ctz16/PF-H_FeedbackControl/ref/Development of Plasma Feedback Control System in TST-2 - Copy.pptx

## Development of Plasma Feedback Control System in TST-2 Spherical Tokamak

Chang Tingzhi
2019. 8.27

## Introduction

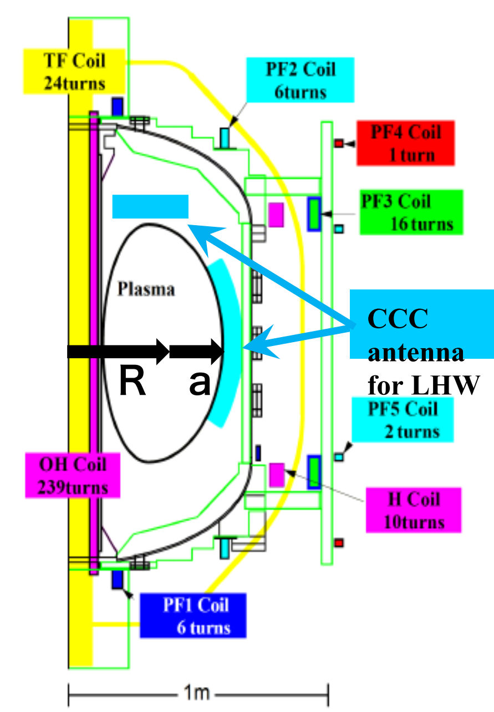
[picture p4: figure]

- In TST-2, PF3 and H coil are used to control the horizontal and vertical position of plasma
- The current waveform of coils is controlled by sending preprogrammed signals to the IGBTs. The waveform is adjusted manually.

## Introduction

- The feedback control system serves to control the plasma position automatically according to a real-time calculation of plasma position, which helps to get a more stable plasma position especially during a long-lasting discharge

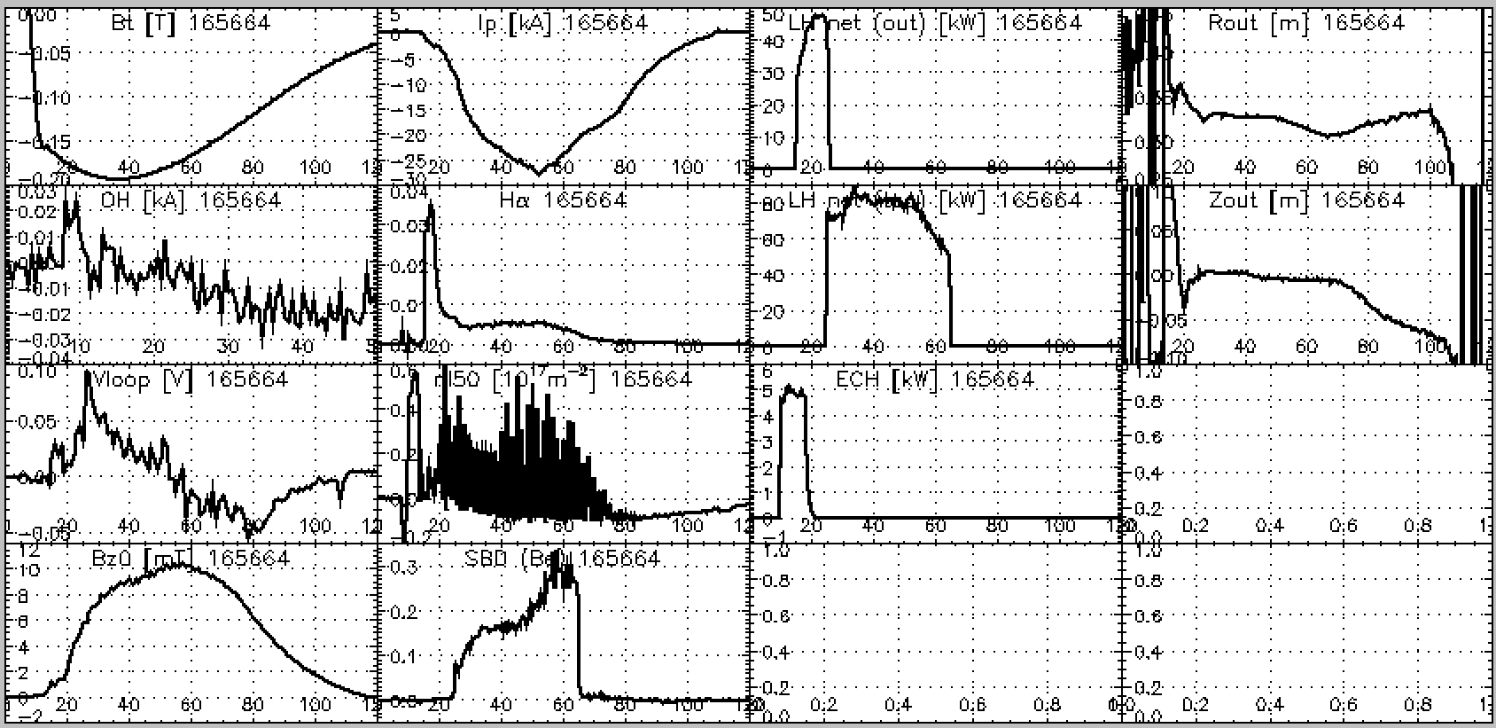
[picture p5: figure]
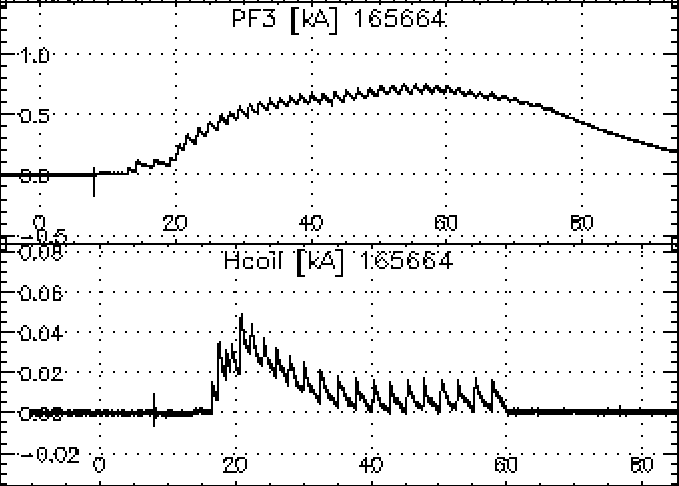
[picture p6: figure]

## Sketch of Control System


- In idle time, controller works to communicate and calculate signal offsets due to integrator offsets.
- Preprogrammed waves and all calibration coefficients can be sent by TCP communication
- When trigger comes in, trigger flag is set by interrupt, the controller will enter controlling process in next loop

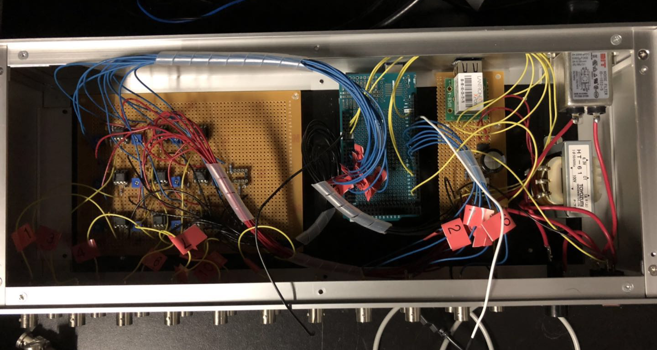
[picture p7: figure]
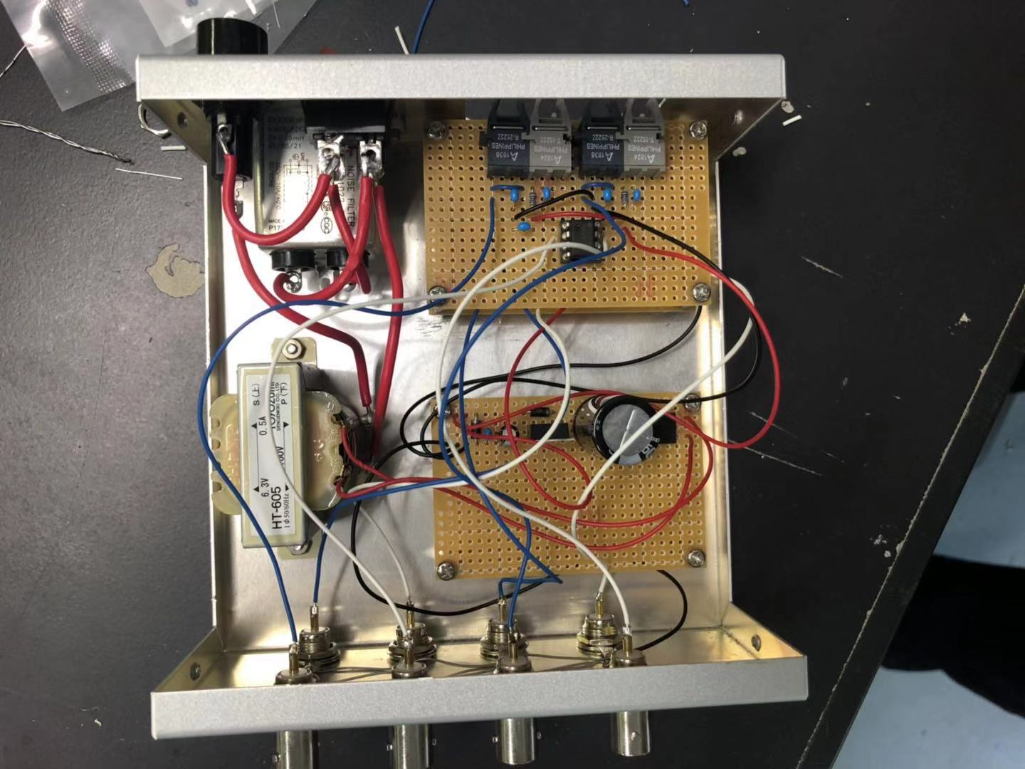
[picture p8: figure]
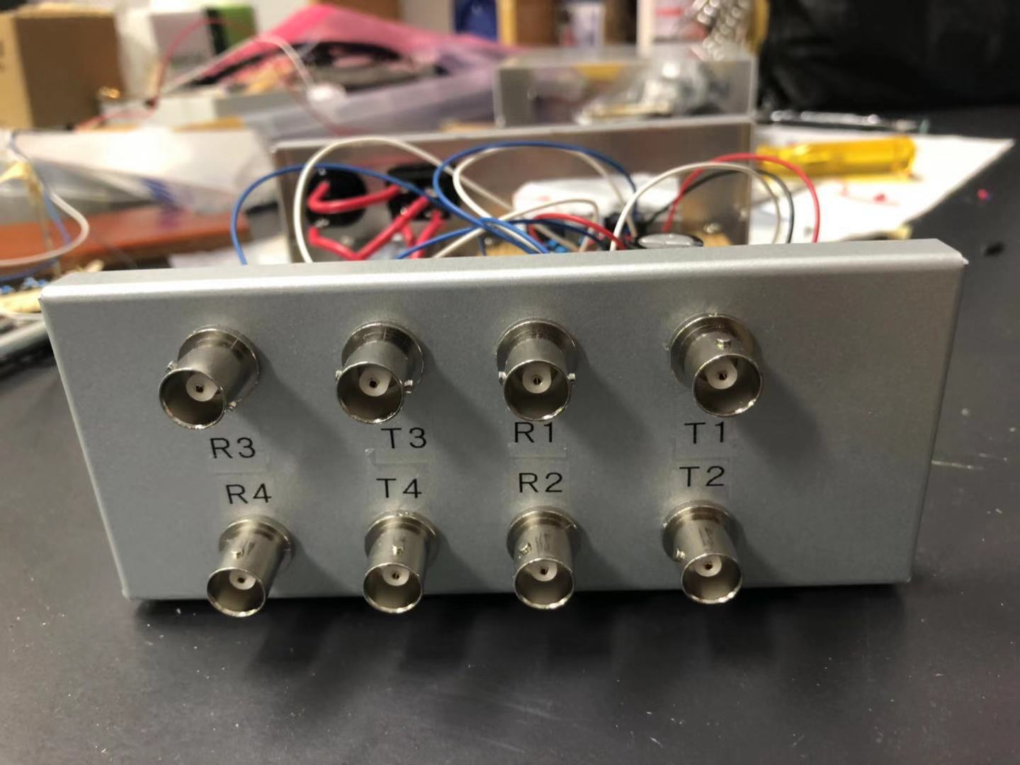
[picture p9: figure]

## IGBT circuit

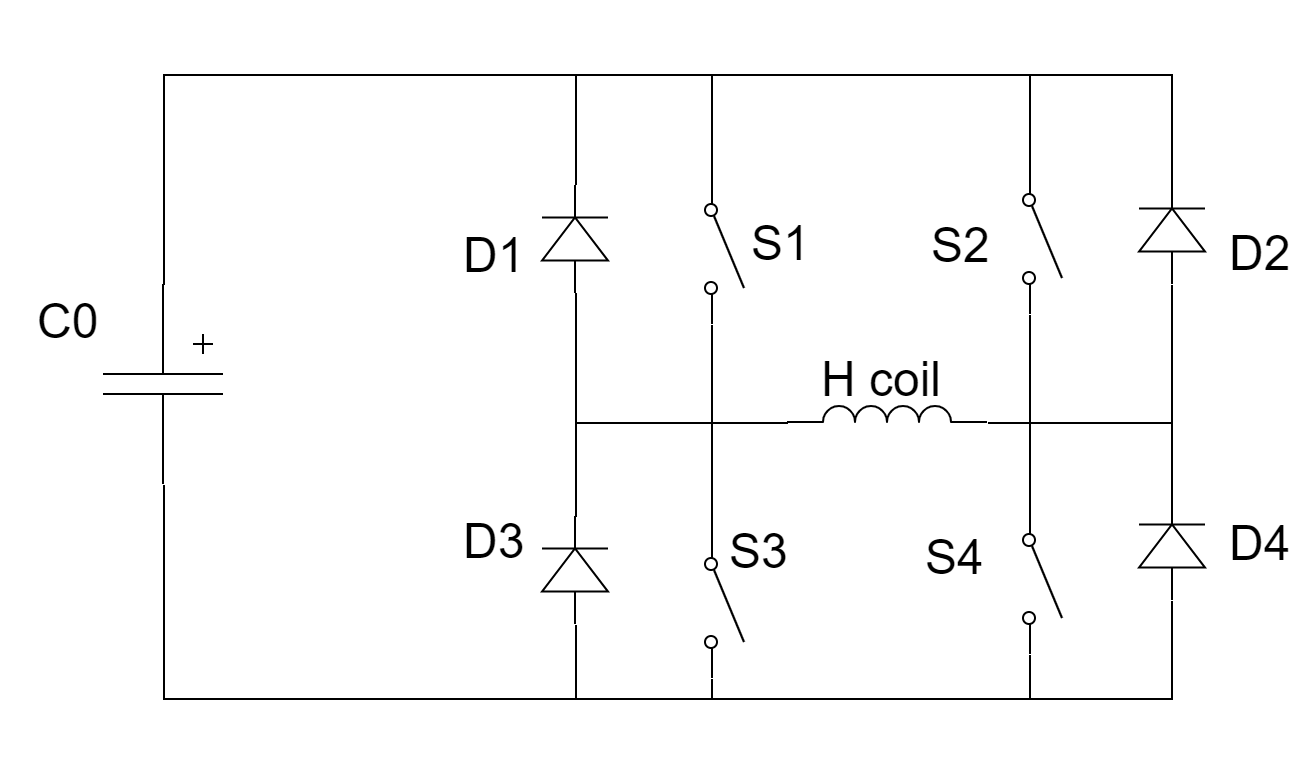
[picture p10: figure]

- H coil control (current flows two direction: H bridge)
  - Group1: S1 & S4 (PWM)
  - Group2: S2 & S3 (PWM)
- PF3 coil control
  - S0 (PWM)

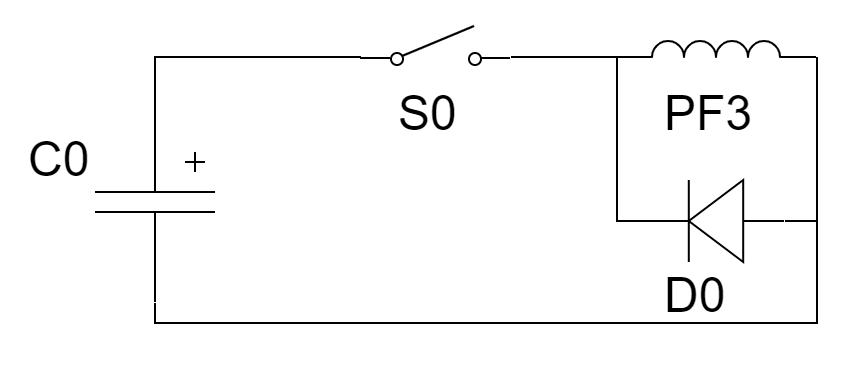
[picture p11: figure]

## Position Control

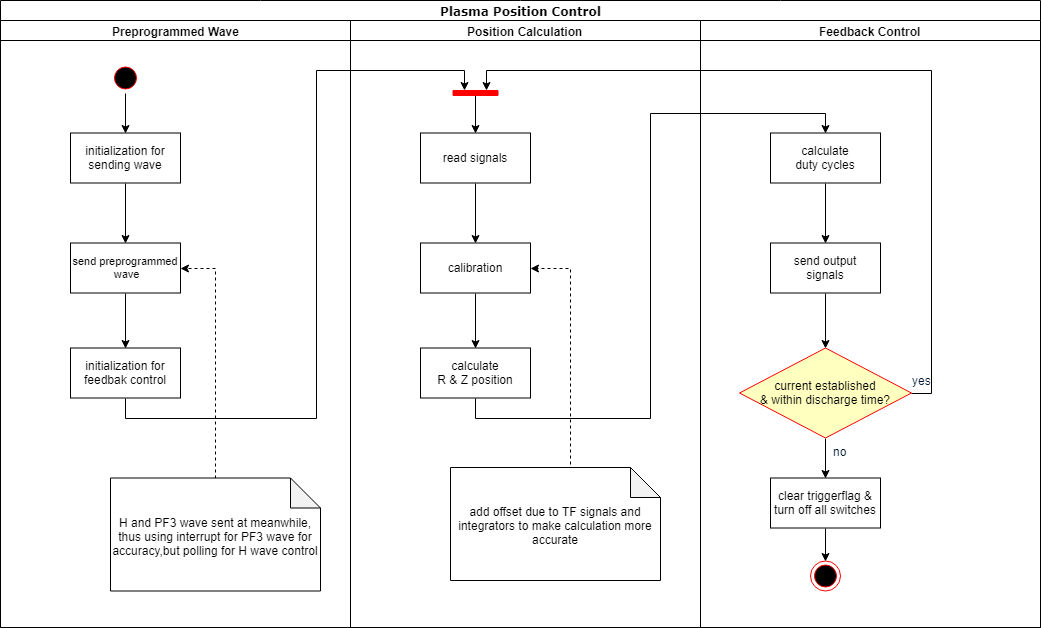
[picture p12: figure]

## Plasma position calculation

Z position:
Fitting of seven magnetic flux in a vertical line, take the position of the minimum value as central z position of plasma
R position:
take the middle of central and outboard flux loop, with a calibration term by ψ
R_(out) =1/2×(R_o +R_c +((ψ_c −ψ_o ))/((dψ)/(dR)))

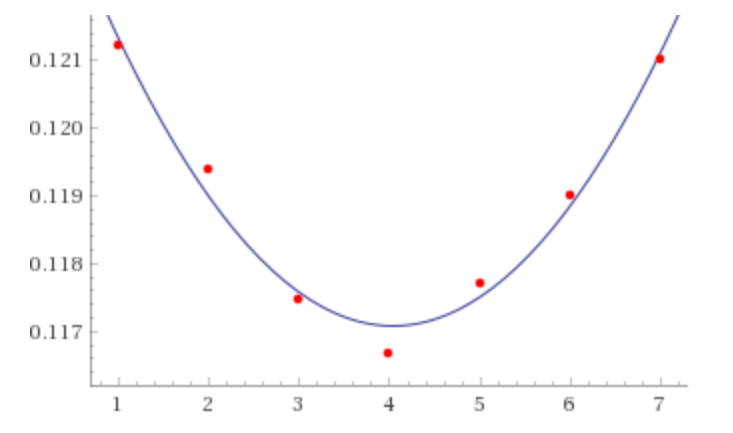
[picture p13: figure]

Z_(out)

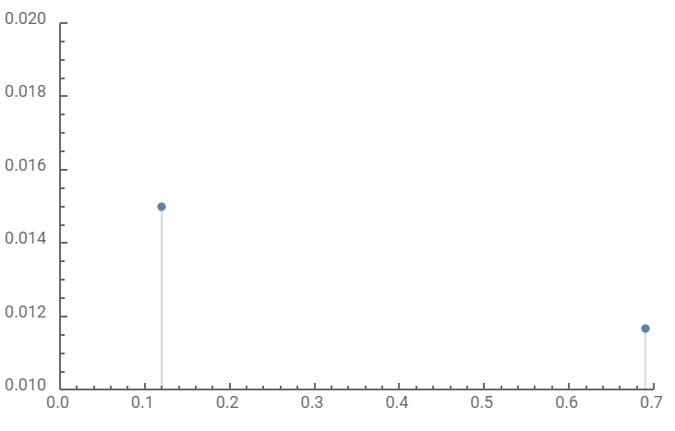
[picture p14: figure]

R_C

R_(out)

R_o

## Feedback control

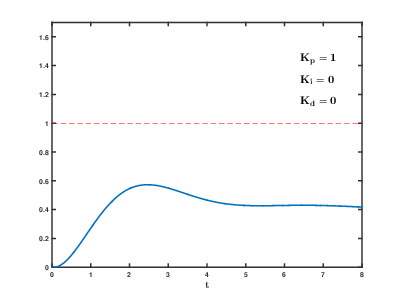
[picture p15: figure]

- PI control
d(t)=K_p e(t)+K_i ∑_0^t e(t)
e_x (t)=x_(out) −x_(target) , x=R,z
- Tuning
  - Increase of P coefficient shows an increase of oscillation but the system reacts faster
  - Increase of I coefficient accelerates convergence, but may cause the overshot at the beginning

## Calculation results (LH)

+++ controller results

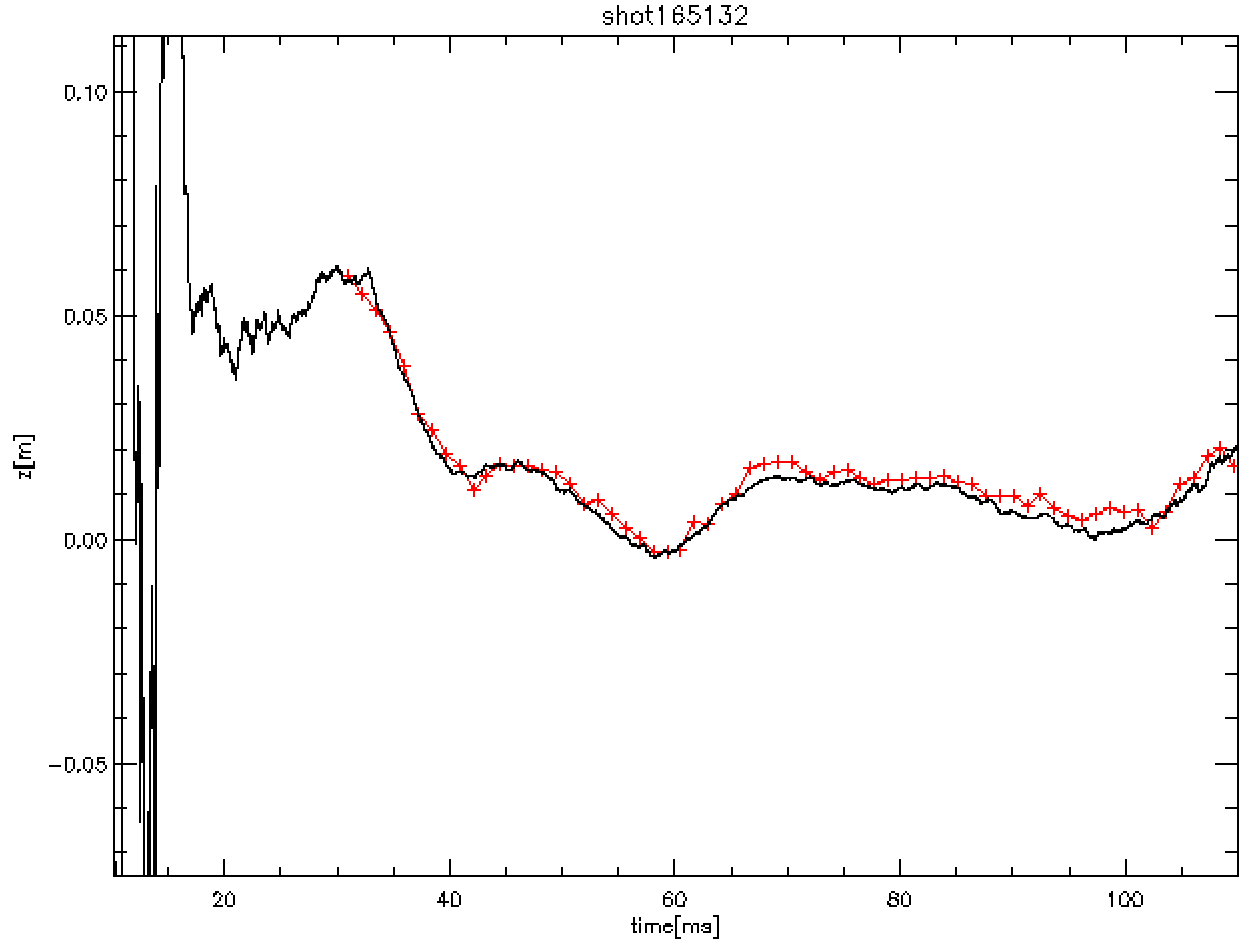
[picture p16: figure]
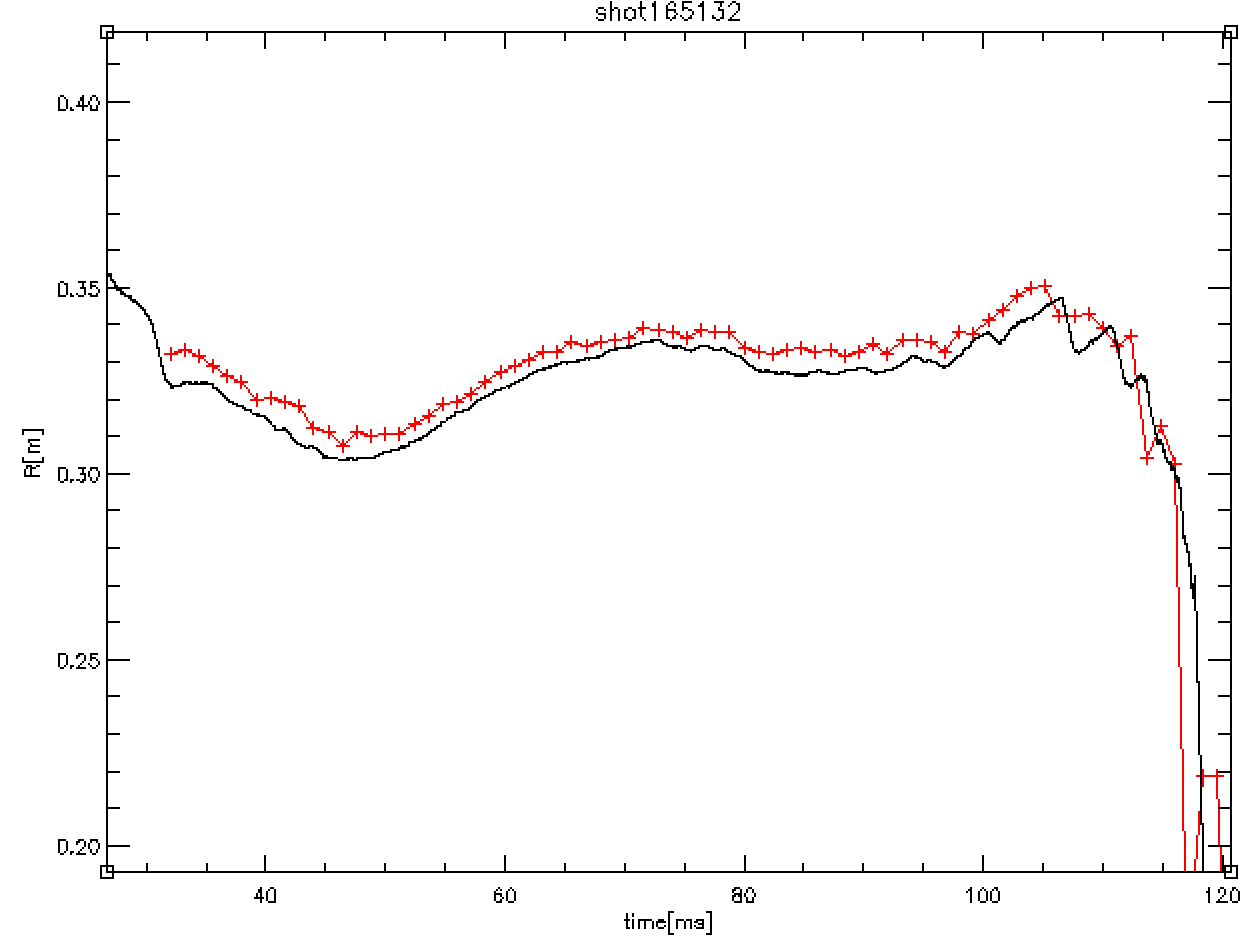
[picture p17: figure]

- A systematic error generally within 1cm (get better when applied noise reduce, TF offset calibration may not be accurate)
- Z calculation is more accurate than R due to TF offset in R calculation

## Calculation results (OH)

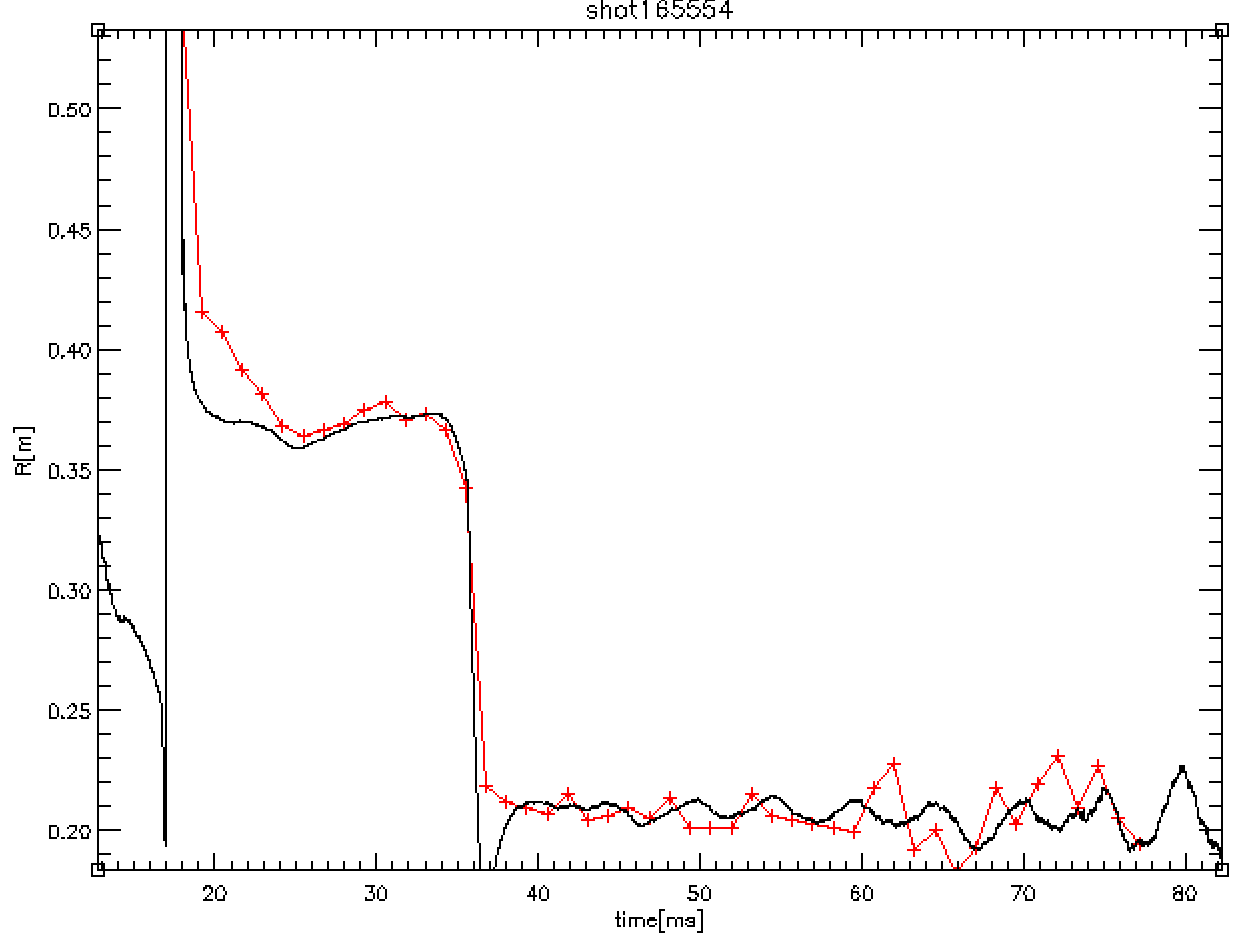
[picture p18: figure]
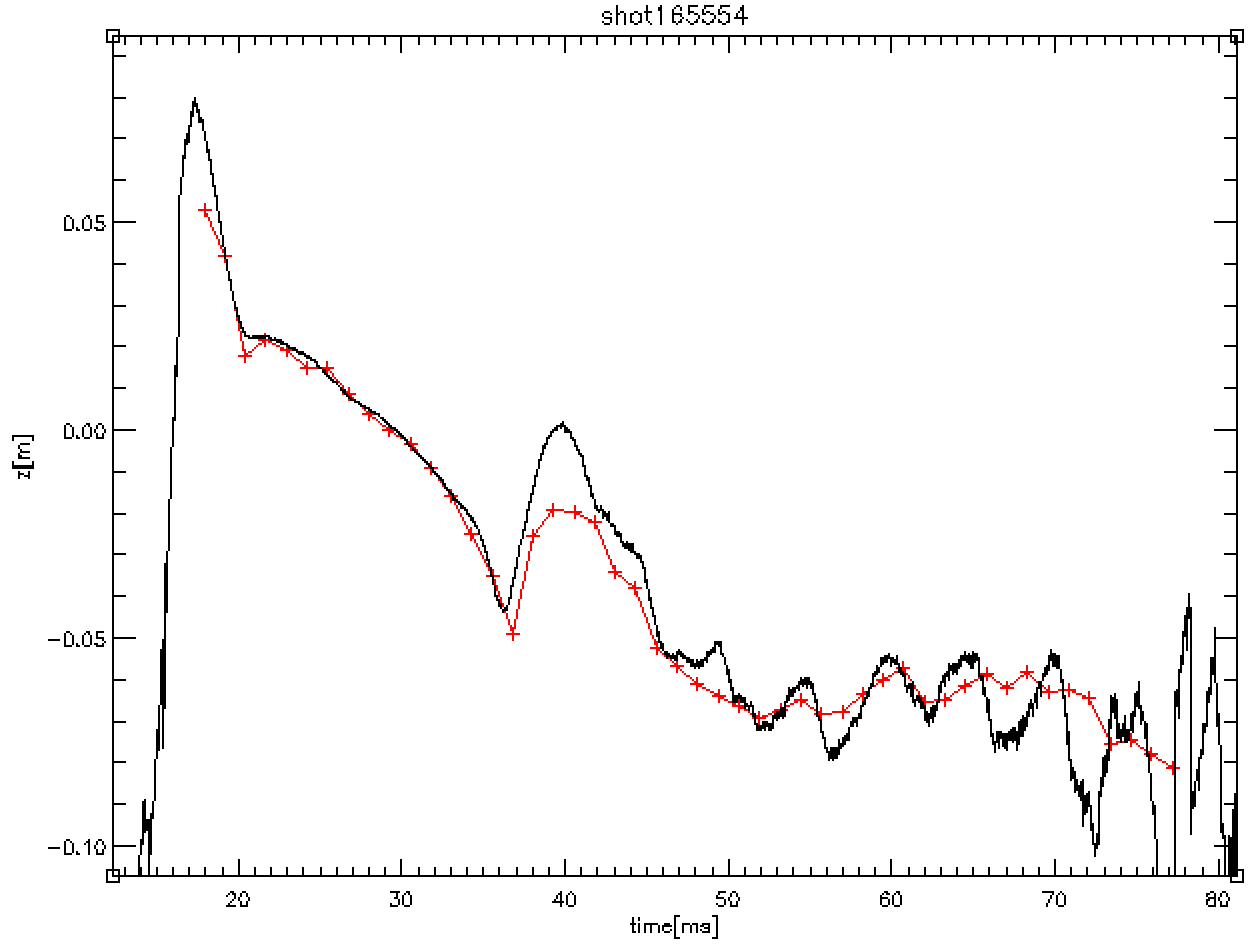
[picture p19: figure]

- Improvement of TF calculation helps to improve R calculation
- Calculation less accurate when signal changes quickly or signal is weak
- Arduino calculation is slow, may not be able to control Ohmic discharge

## Controlling results (LH experiment)

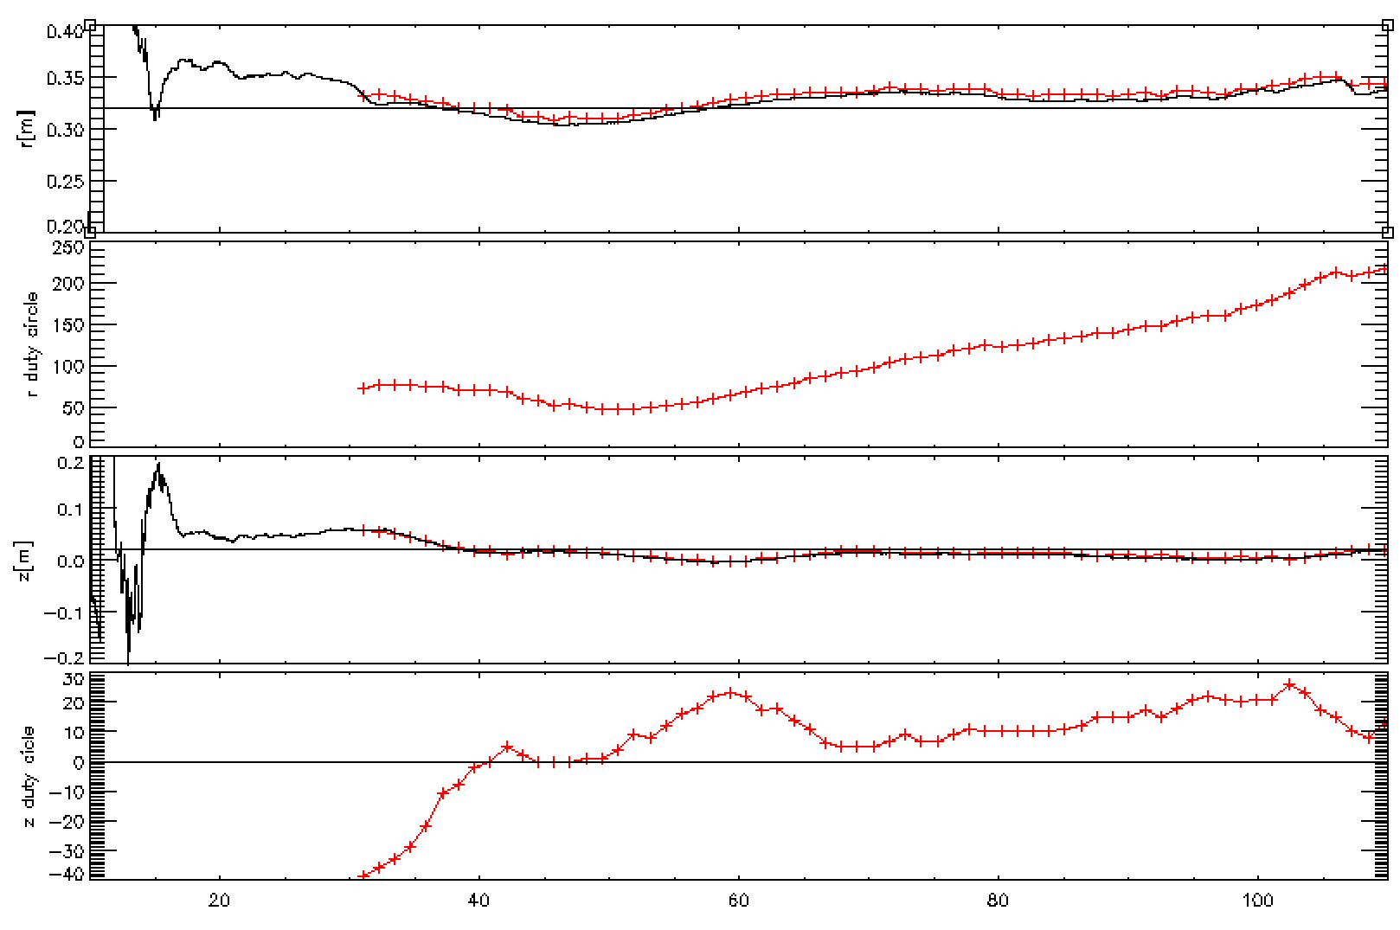
[picture p20: figure]

- Plasma position was controlled at the target with an maximum error of about 2 cm, stability was improved by adjusting PI parameters
- The speed of Arduino is enough to control LH discharge

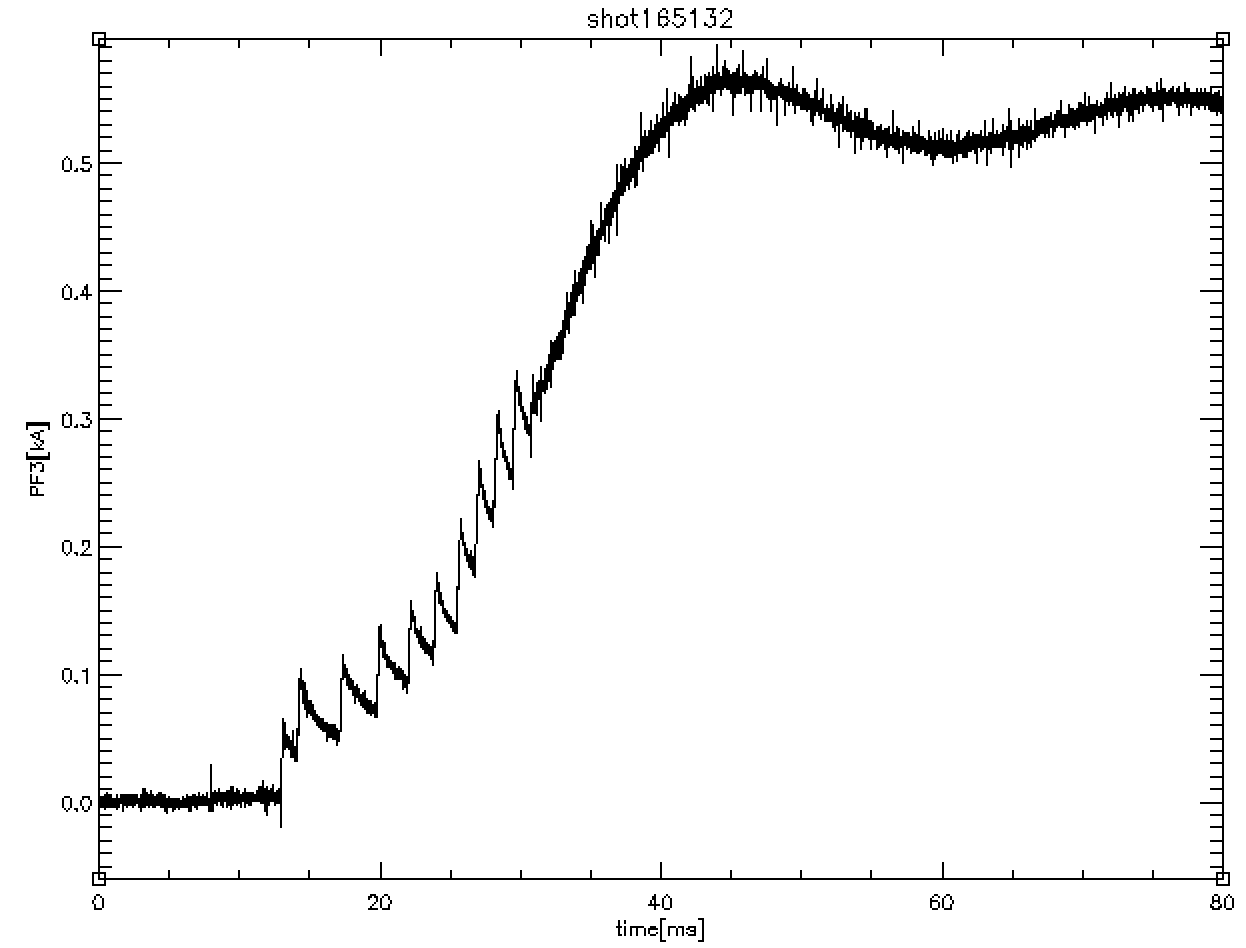
[picture p21: figure]
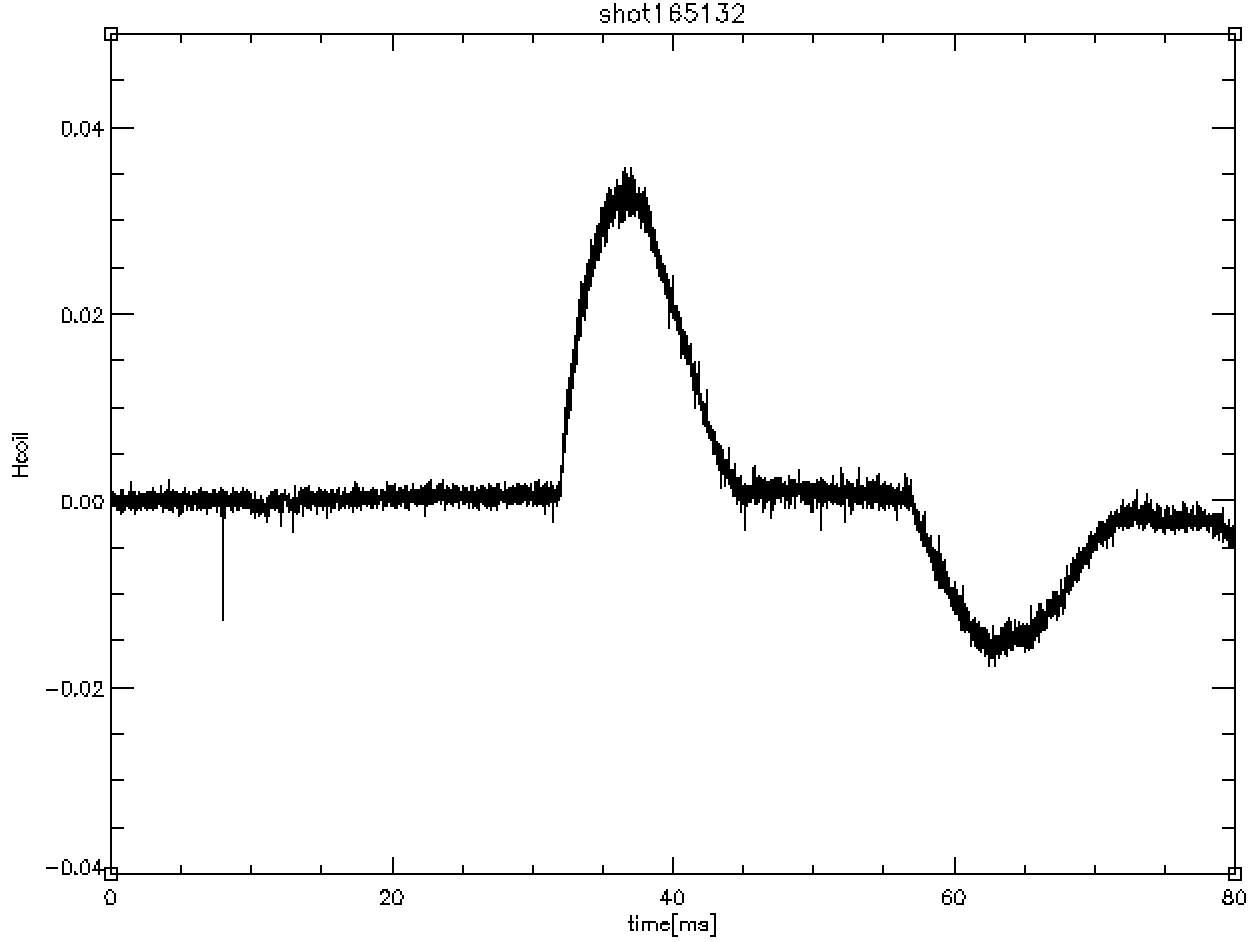
[picture p22: figure]

## Parameter Scan: z target

z target [m]:
—— 0.04 —— 0.02

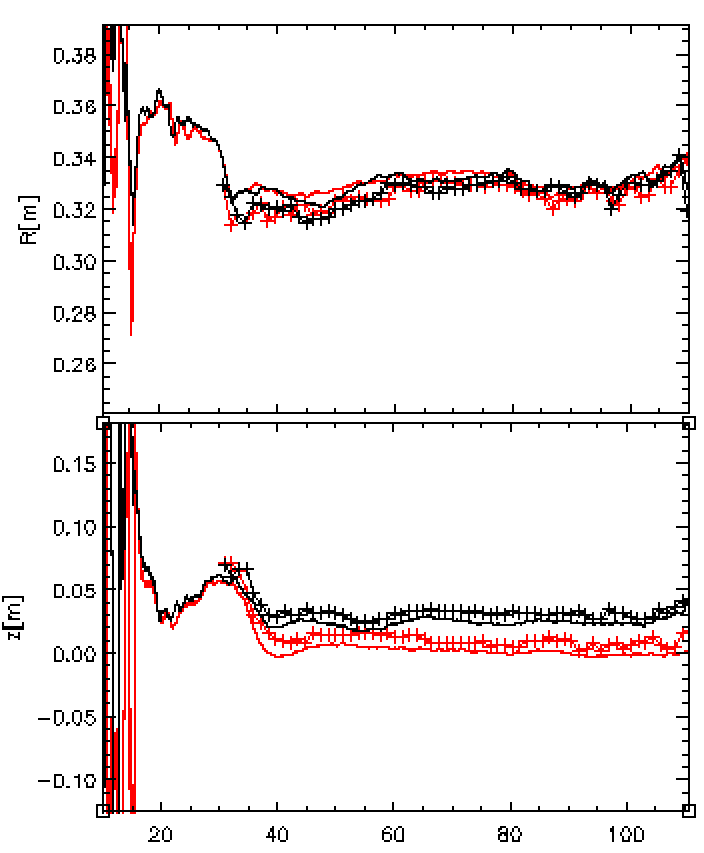
[picture p23: figure]
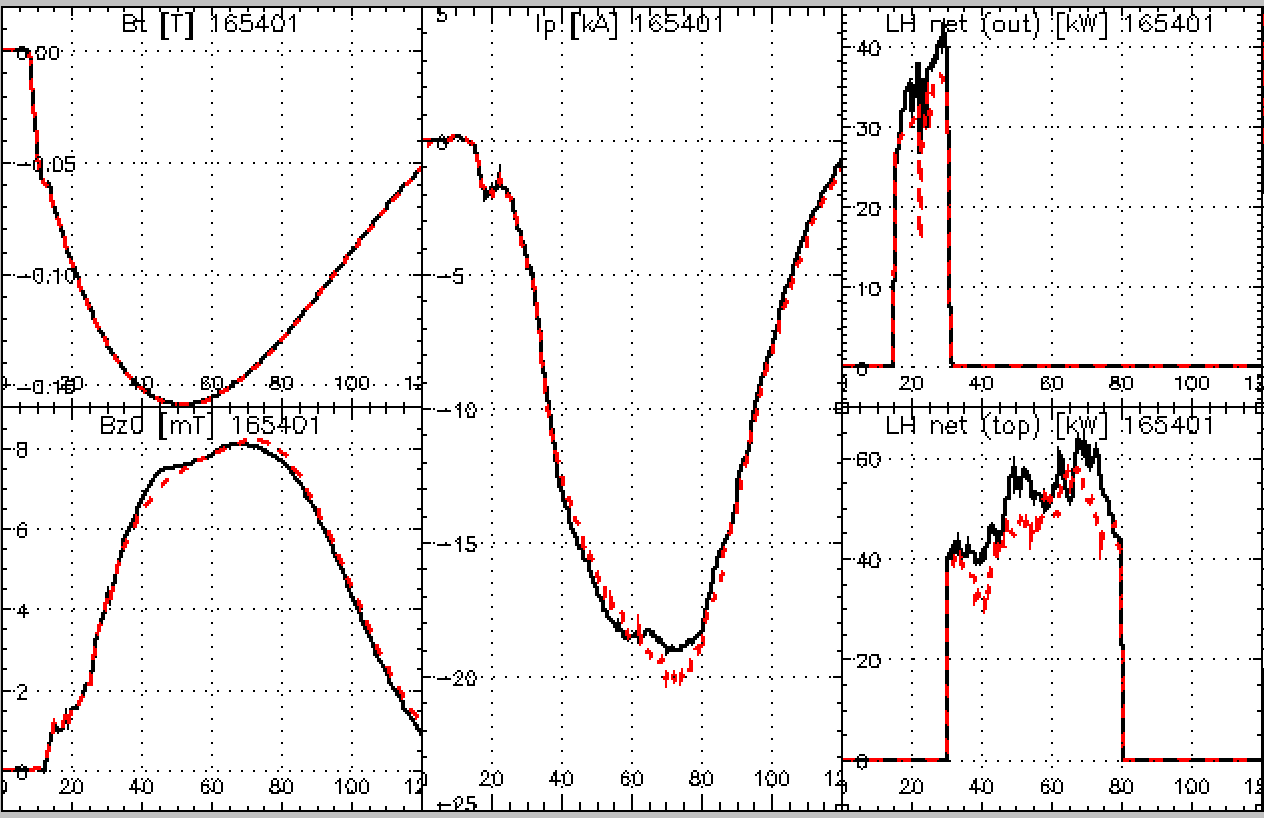
[picture p24: figure]

Changing z target didn’t show a big influence on plasma confinement

## Parameter scan: R target

R target [m]:
—— 0.31 —— 0.32 —— 0.33

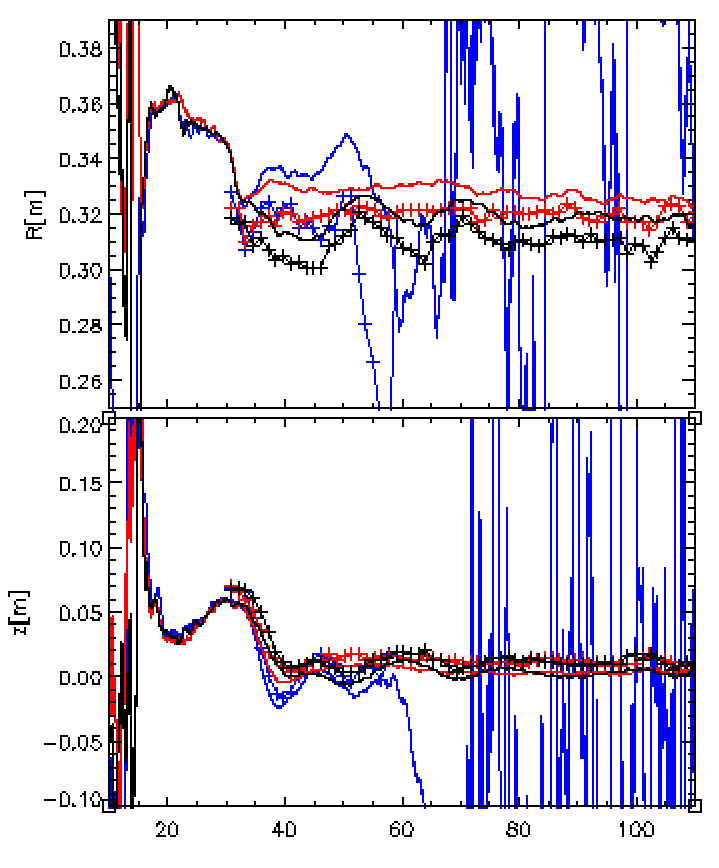
[picture p25: figure]
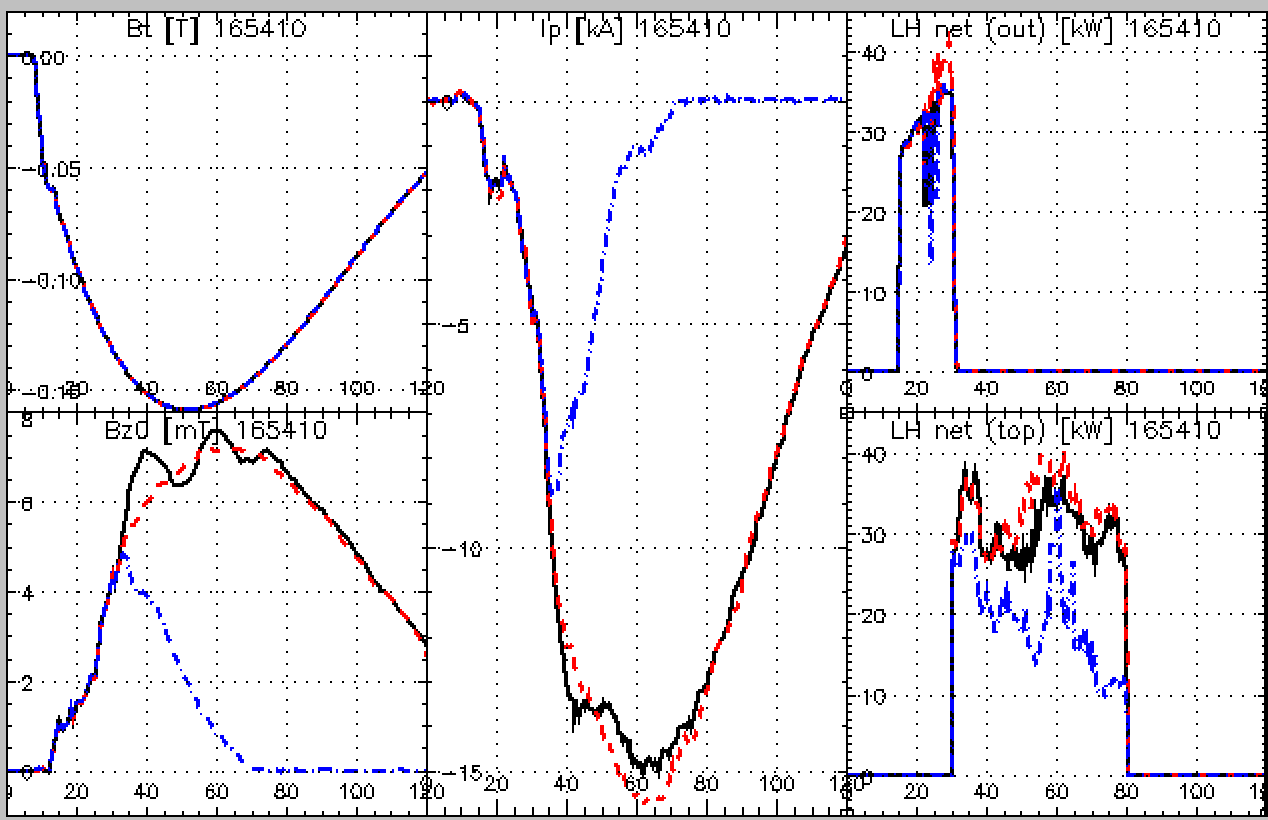
[picture p26: figure]

Plasma showed a sensitive reaction of R position, when R target is bigger, plasma current is more easy to break up (when the target is set to 0.33), optimum R target is around 0.32m,
less oscillation helps to improve current

## Parameter scan: B_t

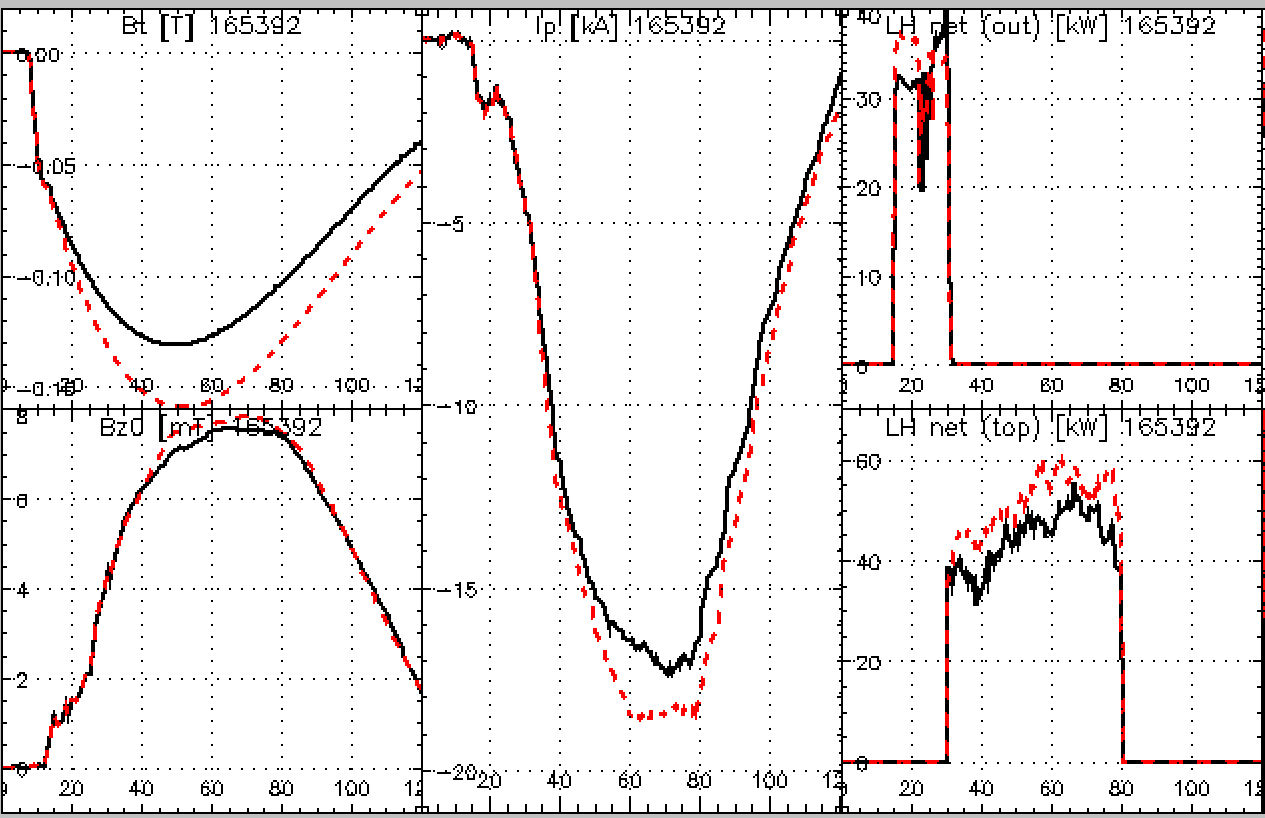
[picture p27: figure]

Bigger toroidal field shows improvement of confinement

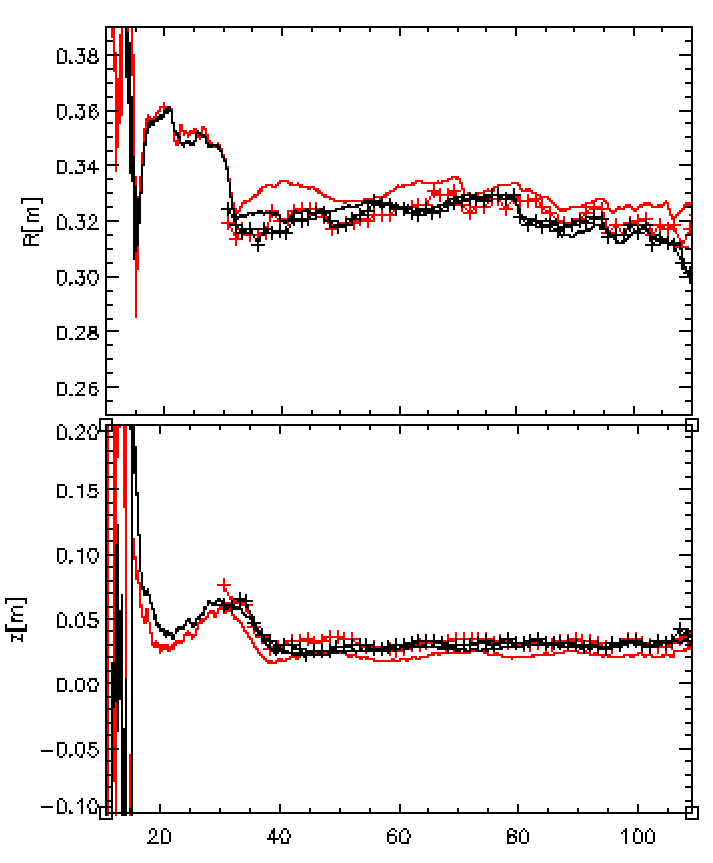
[picture p28: figure]

## Parameter scan: LH power

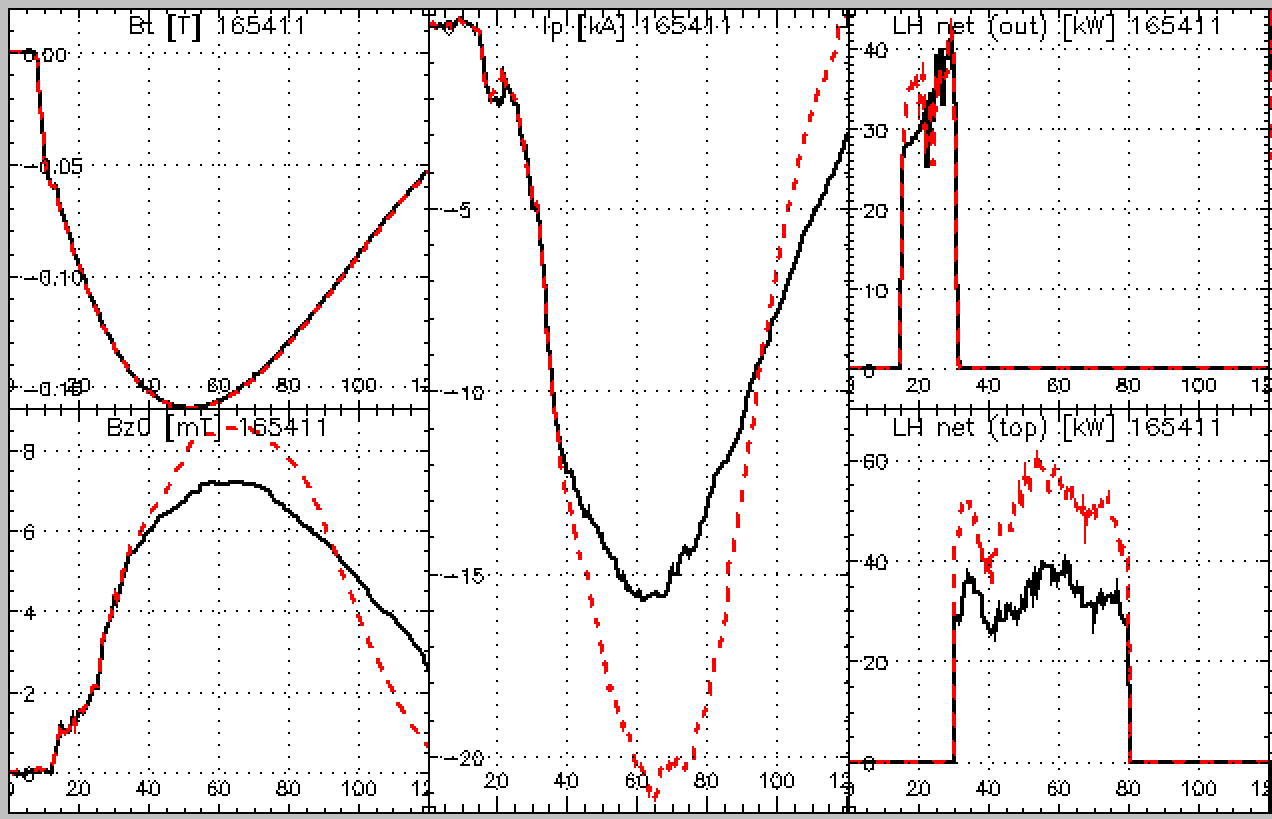
[picture p29: figure]
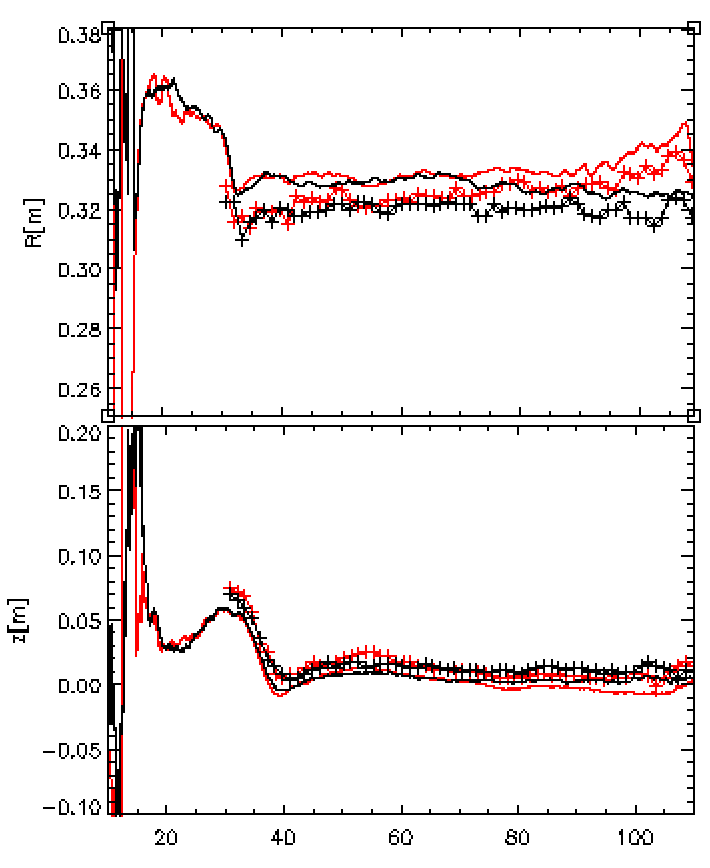
[picture p30: figure]

bigger LH power drives bigger current, but the current dropped faster

## Parameter scan: antenna

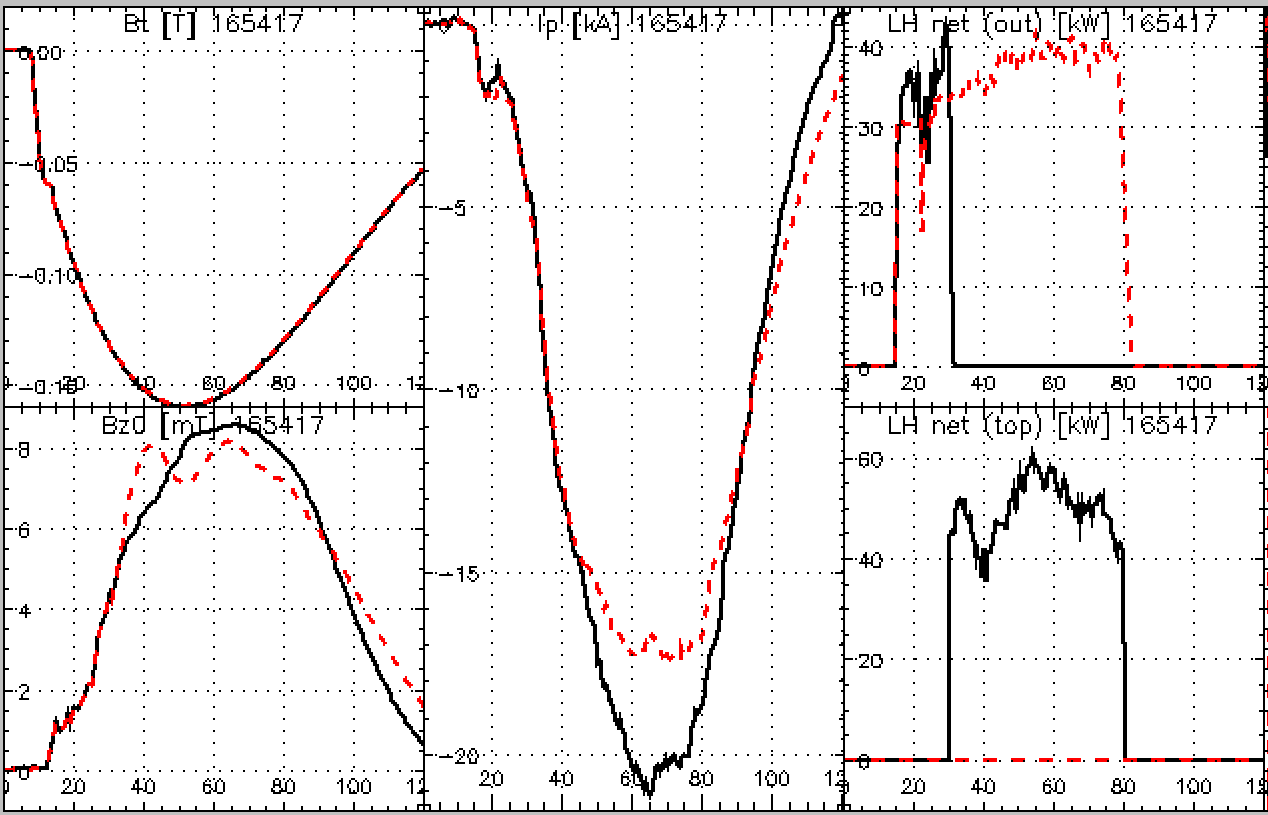
[picture p31: figure]

Top launched antenna is able to drive bigger plasma current (after the current established), the feedback control is sensitive to initial position

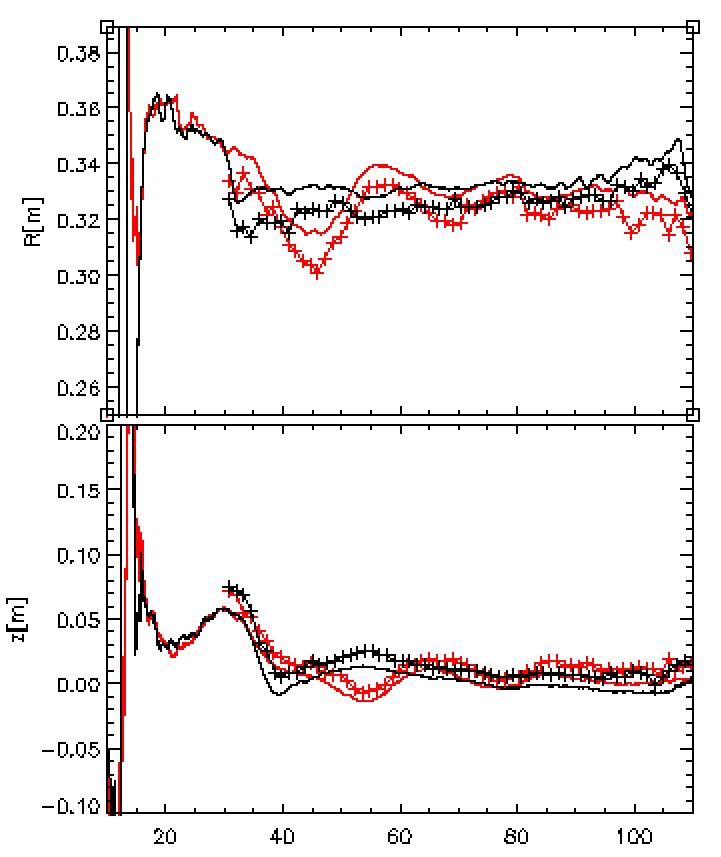
[picture p32: figure]

## Conclusion

- A plasma feedback control system was developed in TST-2 successfully to help control the plasma position in two dimensions, R & Z position can be maintained automatically by the controller
- Calculation of plasma position in R direction is with an error of 1cm but can be improved with more accurate TF offset. Calculation of Z position is better than R, within an error of about 0.5 cm
- Controlling on LH experiment shows a stable control of plasma position within an error of 2 cm to the target in both direction
- Parameter scan shows an optimum R position around 0.32m in LH discharge, the increase of toroidal field, LH power, and using of top launched antenna helps to increase plasma current

## Future work

- The convergence is now is very slow and showed some oscillations, which is sensitive to the initial position more experiment is needed to adjust the P & I parameters
- The processing speed of controller is enough for LH experiment but may not be enough for OH experiment. Therefore we consider to use more powerful controller like FPGAs
