ctz16/PF-H_FeedbackControl/(commit log)

2019-07-10 Czout for arduino use version 1
2019-07-12 combined PID code with position
2019-07-16 ADC adjust to 8 divide, problems less than 8
2019-07-17 modified the PID control to 9 channals input
2019-07-17 modified the PID control of Z
2019-07-19 fixed pwm problem after preprogramed wave
2019-08-09 first successful
    [config.txt]
2019-08-09 8.9 feedback successful for R and Z, only PF3 prewave
    [config.txt]
2019-08-16 add two prewave and tf self offset, not checked yet
    [config.txt]
2019-08-20 PF correct but H not
    [config.txt]
2019-08-21 see 8.21 update
    [config.txt]
2019-08-23 add OH config
    [config.txt, configOH.txt]
2019-08-23 8.23 calculation correct
    [resistorTuning.xlsx]
2019-08-29 prepare for final
    [config.txt, configOH.txt, resistorTuning.xlsx]
2019-08-30 last commit
    [config.txt]
